Tamaras-hub/TST-AI-Smart-Desktop-Assistant-with-Pomodoro/images/tokens_requests.png

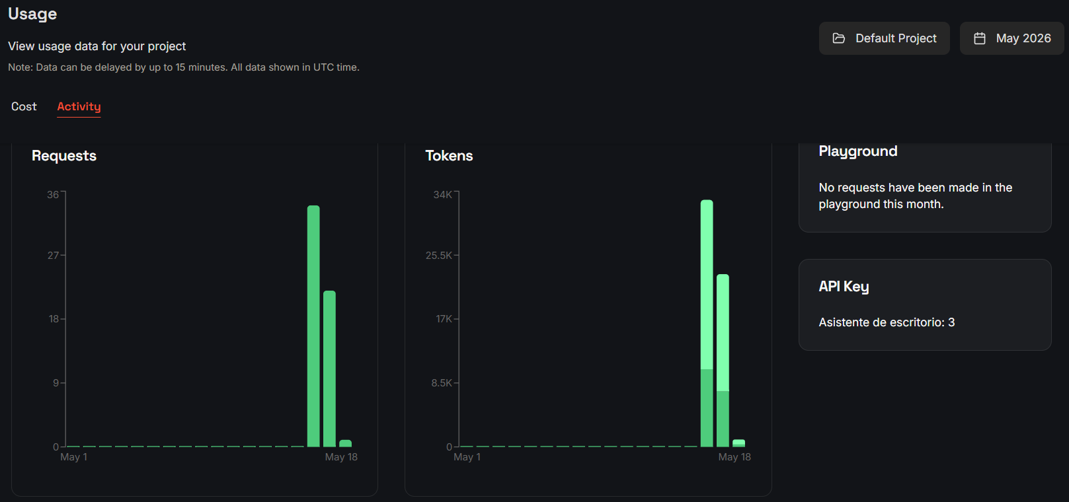
images/tokens_requests.png
