Tamaras-hub/TST-AI-Smart-Desktop-Assistant-with-Pomodoro/(notices)

Notices in the files:
README.md:
License: MIT
